Taro-Hayashi/Handyman/led_EN.md

Align the notch of the LED with the corner of the silk print and solder it.  
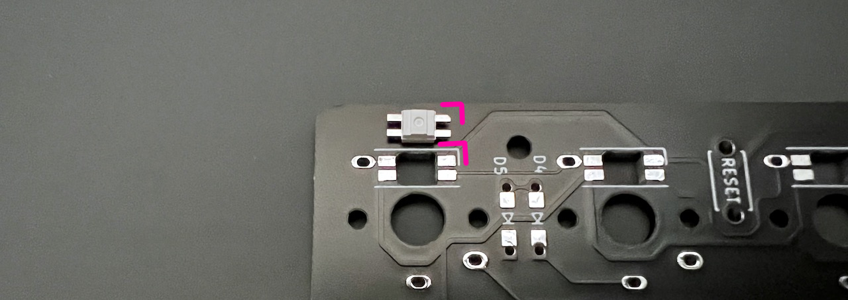
[picture p48: img/IMG_1039.jpg]
    
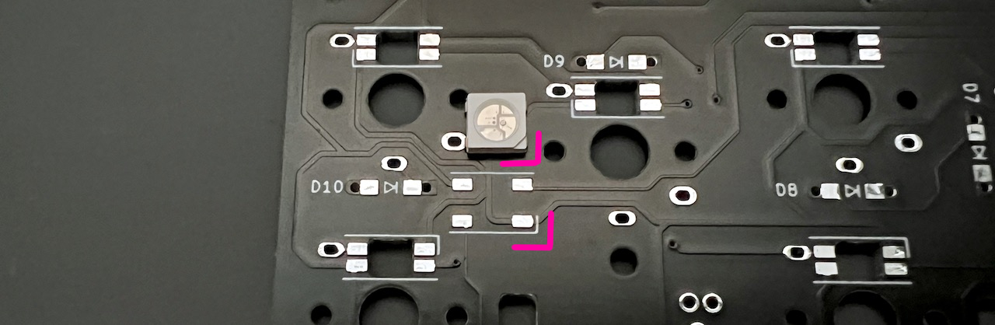
[picture p49: img/IMG_1049.jpg]
  
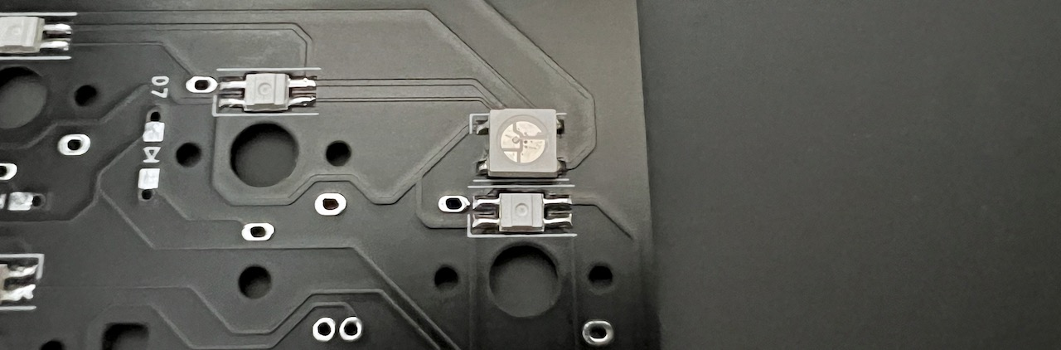
[picture p50: img/IMG_1059.jpeg]
    

Make sure the orientation is correct from the surface.
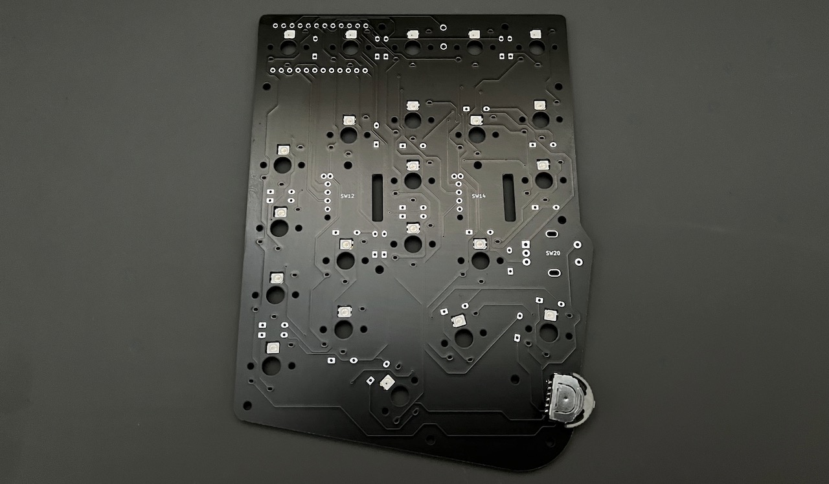
[picture p51: img/IMG_1068.jpeg]
