Taro-Hayashi/Handyman/firmware.md

## QMK Toolboxを使ったファームウェア更新方法

QMK Toolboxのreleaseページから最新版をダウンロードしてインストールください。  
- [Releases・qmk/qmk_toolbox](https://github.com/qmk/qmk_toolbox/releases)

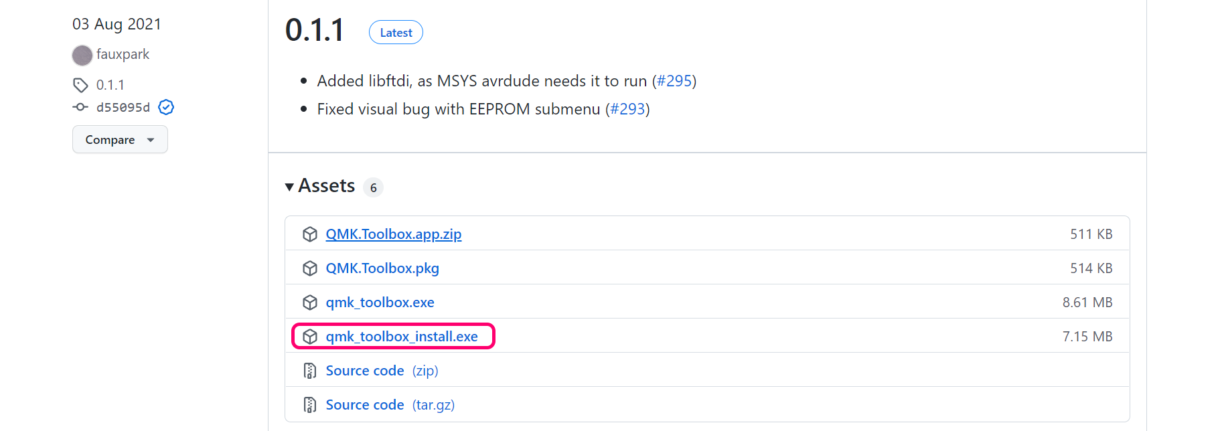
[picture p52: img/release.png]
  
起動したらOpenを押してダウンロードしたファームウェアを指定し、キーボード裏面のリセットボタンを素早く2回押します。  
   
新しく黄色の文字が出てきたらFlashを押します。  
  

Thank youの後に黄色い文字が出たら更新完了です。  
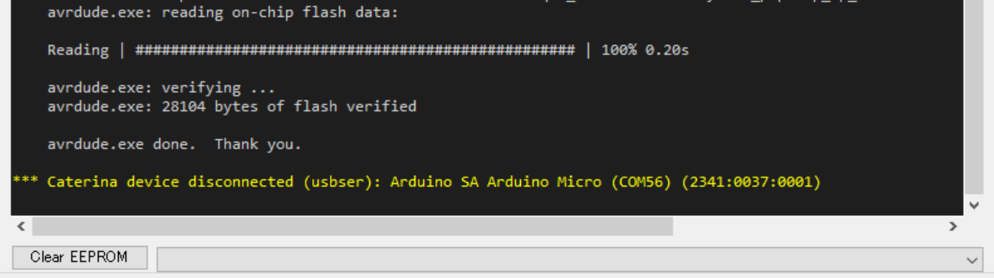
[picture p53: img/qmktoolbox3.png]
