Taro-Hayashi/Handyman/ble.md

# 電池ボックスの使い方
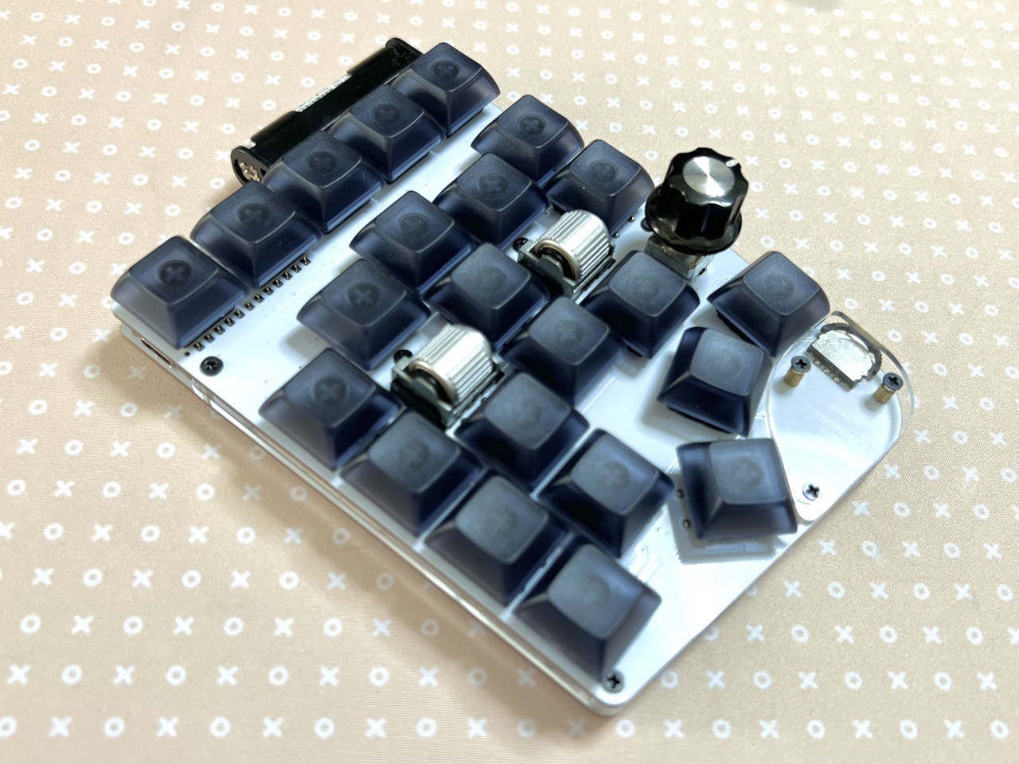
[picture p54: img/IMG_0909.jpg]


## 用意するもの
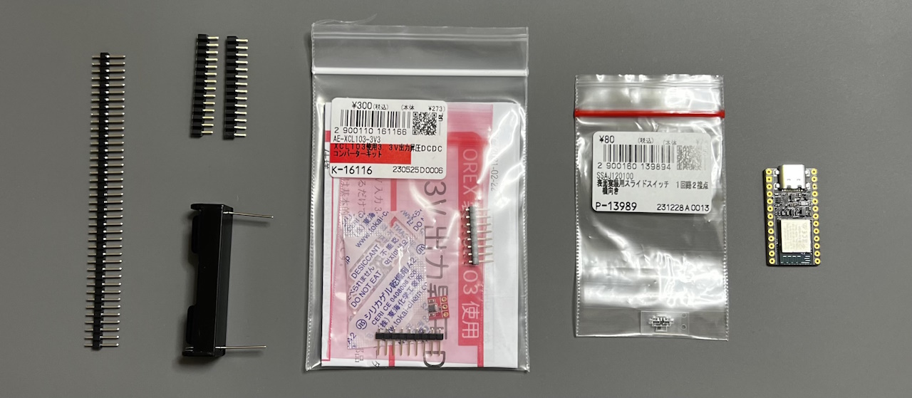
[picture p55: img/IMG_0746.jpg]


|部品（購入先の例）|個数|
|-|-|
|[ピンヘッダー](https://akizukidenshi.com/catalog/g/g100167/)|合計26ピン以上|
|[シングルピンソケット](https://akizukidenshi.com/catalog/g/g100661/)|合計26ピン以上（リンク先なら2個）|
|[電池ボックス 単4](https://akizukidenshi.com/catalog/g/g102670/)|1|
|[XCL103使用3.3V出力昇圧DCDCコンバーターキット](https://akizukidenshi.com/catalog/g/g116116/)|1|
|[スライドスイッチ](https://akizukidenshi.com/catalog/g/g113989/)|1|
|[BLE Micro Pro](https://shop.yushakobo.jp/products/ble-micro-pro)|1|

> [!NOTE]
> はんだ付けの難しいパーツがあります。  
> BLE Micro Proの使い方は製品のサイトをご覧ください。  
> ピンソケットの代わりに3.5mm コンスルーでの取り付けも可能です。

## 組み立て
スライドスイッチを取り付ける場所に予備はんだを盛ります。
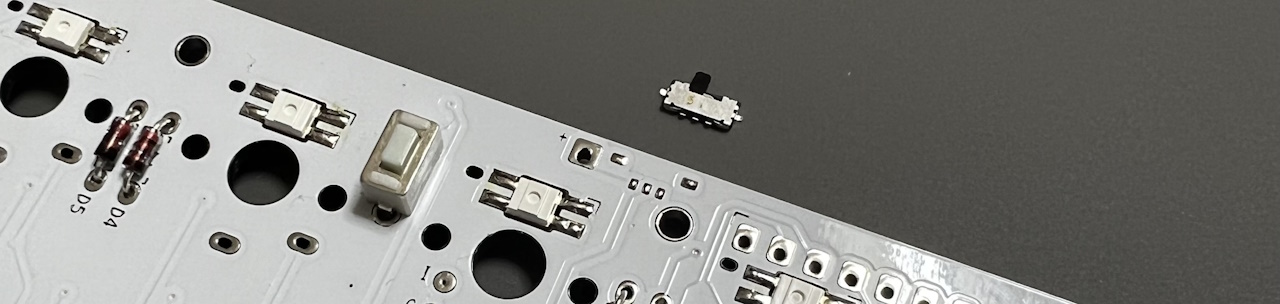
[picture p56: img/IMG_0752.jpg]


スライドスイッチをはんだ付けします。
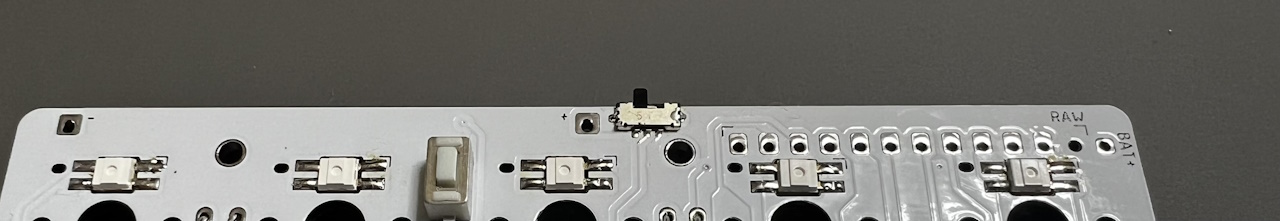
[picture p57: img/IMG_0755.jpg]


ダイオードやピンヘッダの足の切れ端をDCDCコンバーター用のパッドに立てるようにはんだ付けします。
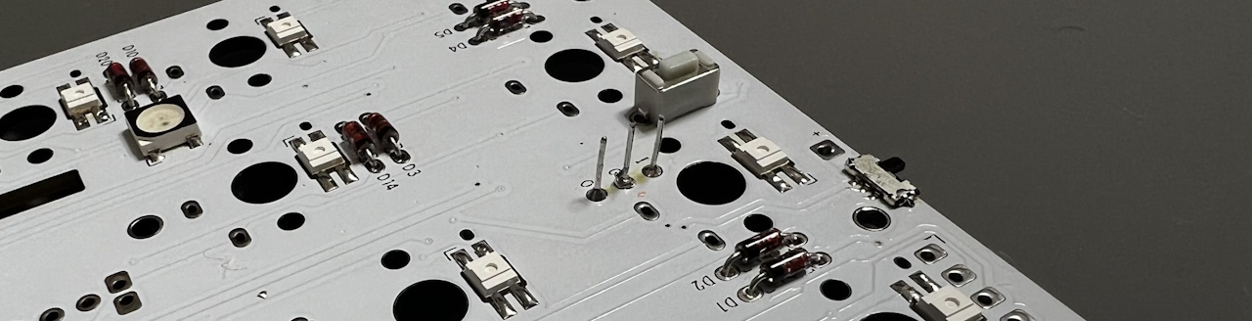
[picture p58: img/IMG_0756.jpg]


I、G、Oの位置に注意してDCDCコンバーターをはんだ付けします。

> [!NOTE]
> 出来るだけ全高が低くなるようにはんだ付けしてください。

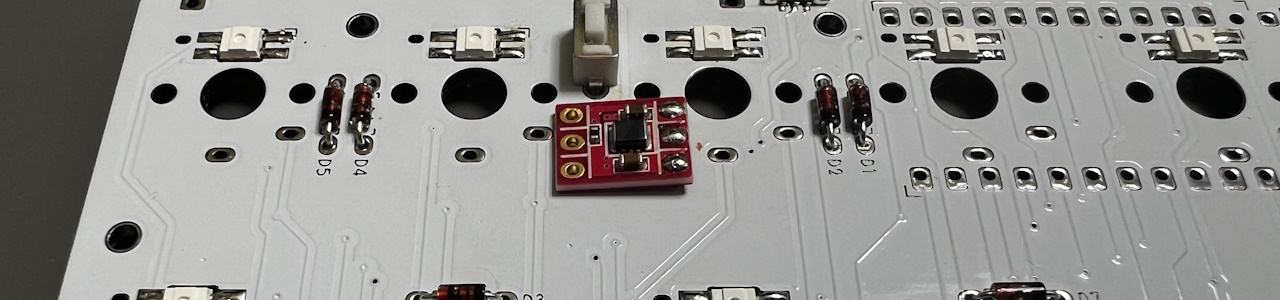
[picture p59: img/IMG_0758.jpg]

BLE Micro Proにピンソケットをのせ、ピンヘッダを差し込みます。

> [!WARNING]
> 上下に気を付けてください。

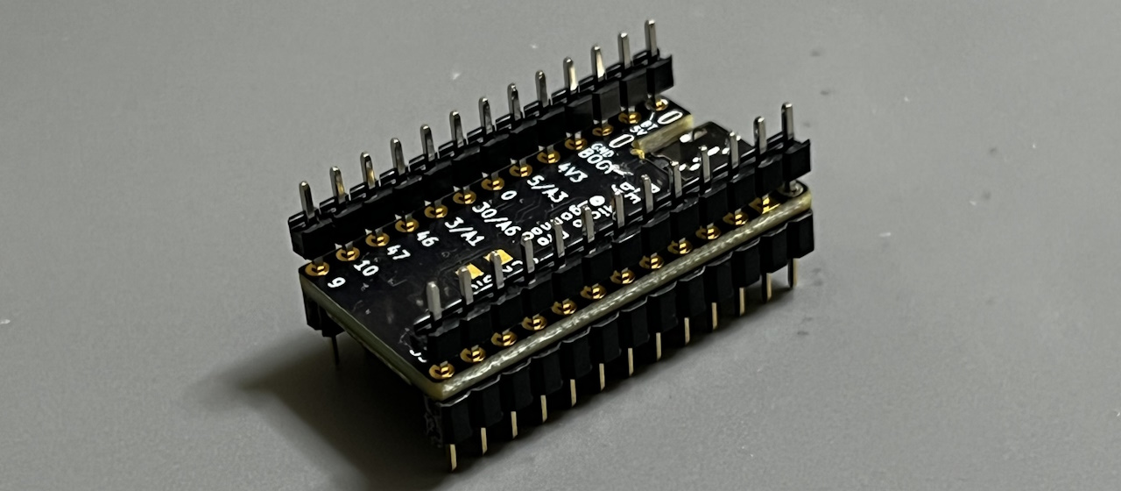
[picture p60: img/IMG_0772.jpg]

メインボードに差し込み表裏共にはんだ付けします。ピンヘッダは足を切りました。

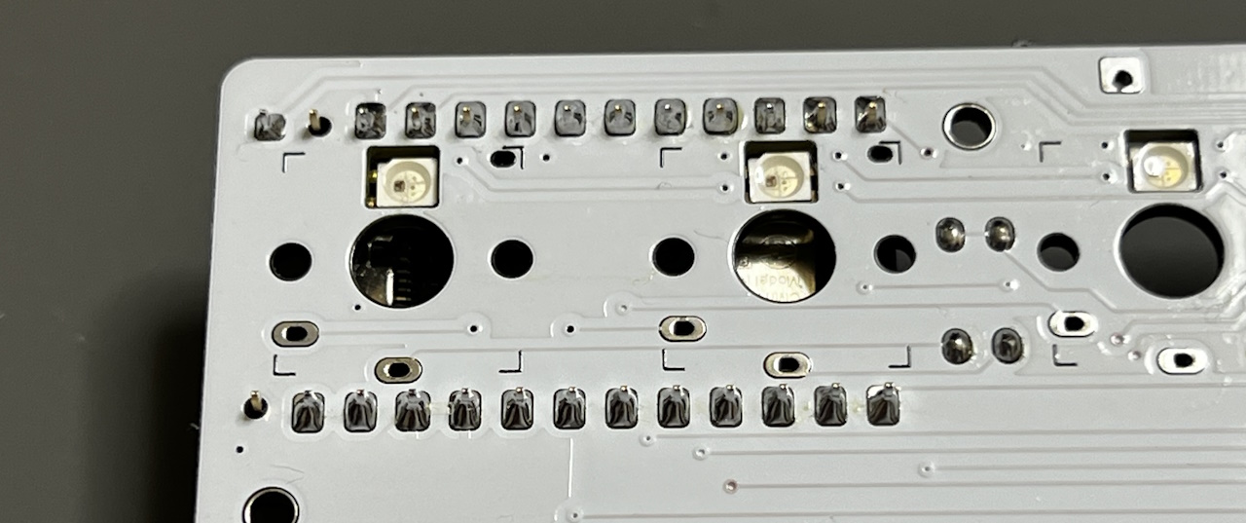
[picture p61: img/IMG_0773.jpg]

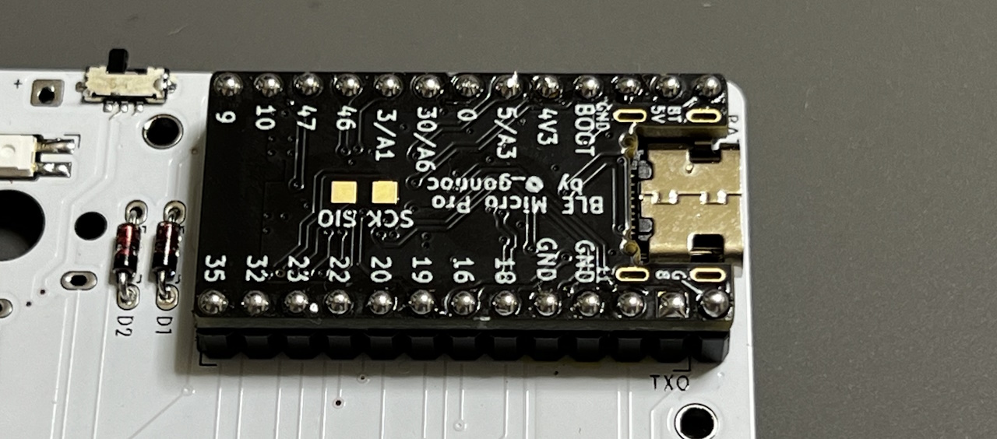
[picture p62: img/IMG_0777.jpg]

電池ボックスのピンを曲げて差し込みます。

> [!WARNING]
> ＋－に気を付けてください。

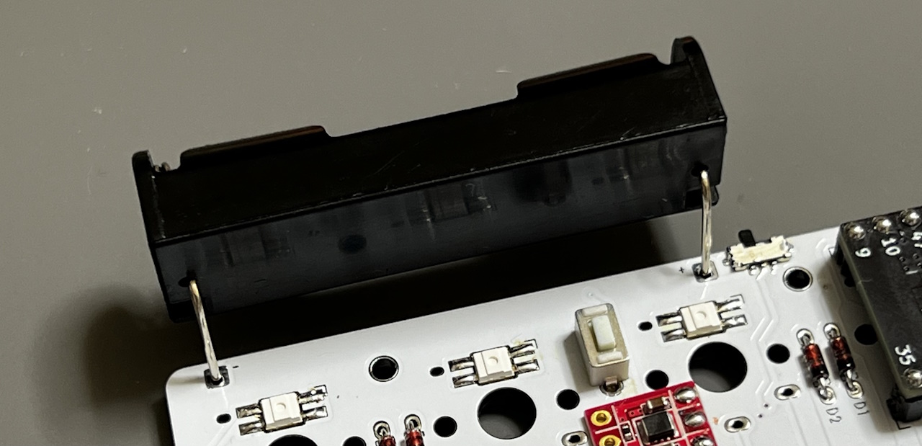
[picture p63: img/IMG_0779.jpg]

両面をはんだ付けします。
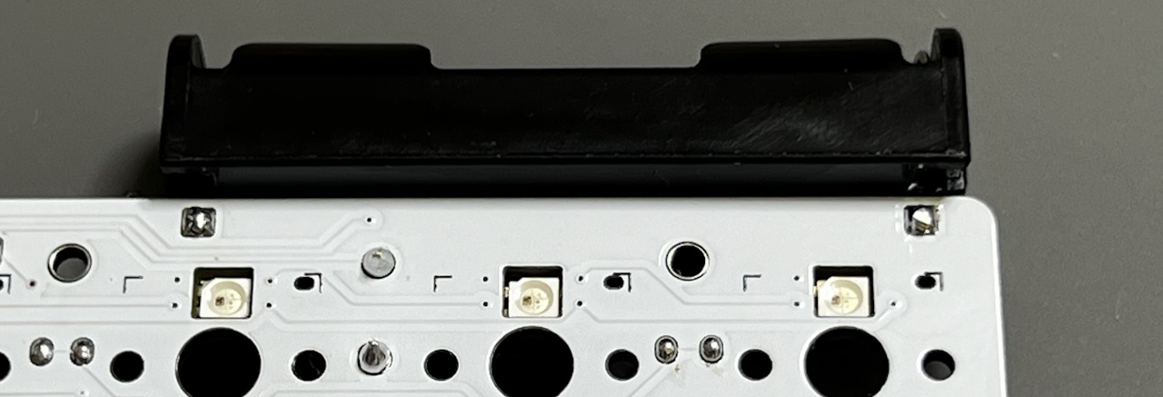
[picture p64: img/IMG_0782.jpg]

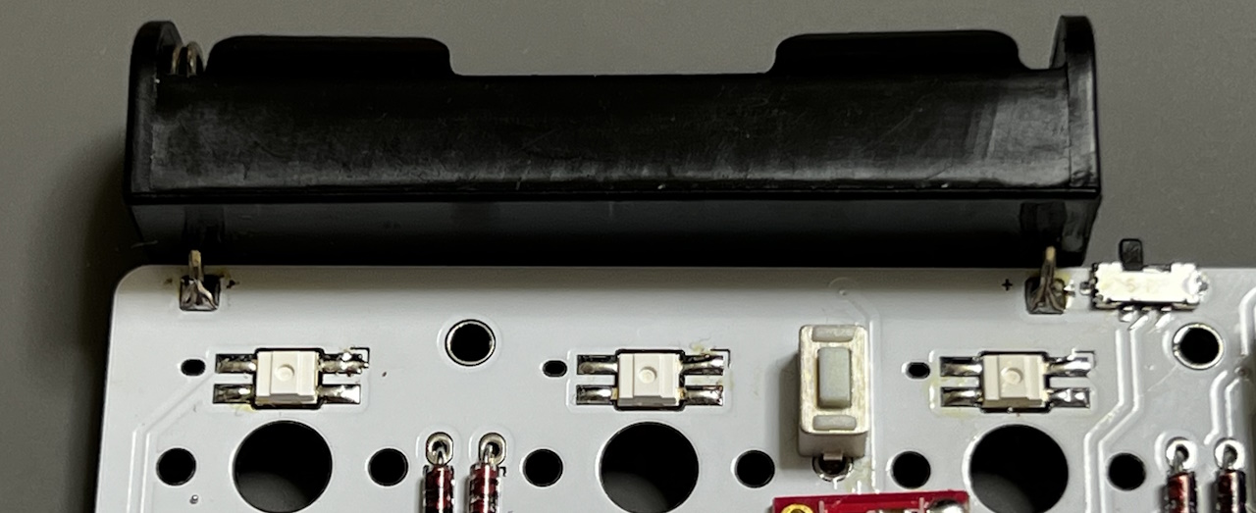
[picture p65: img/IMG_0785.jpg]


電池を入れてスライドスイッチを電池ボックス側に倒すと電源が入ります。  
電圧は画像のようになるのでテスターでチェックする時は参考にしてください。
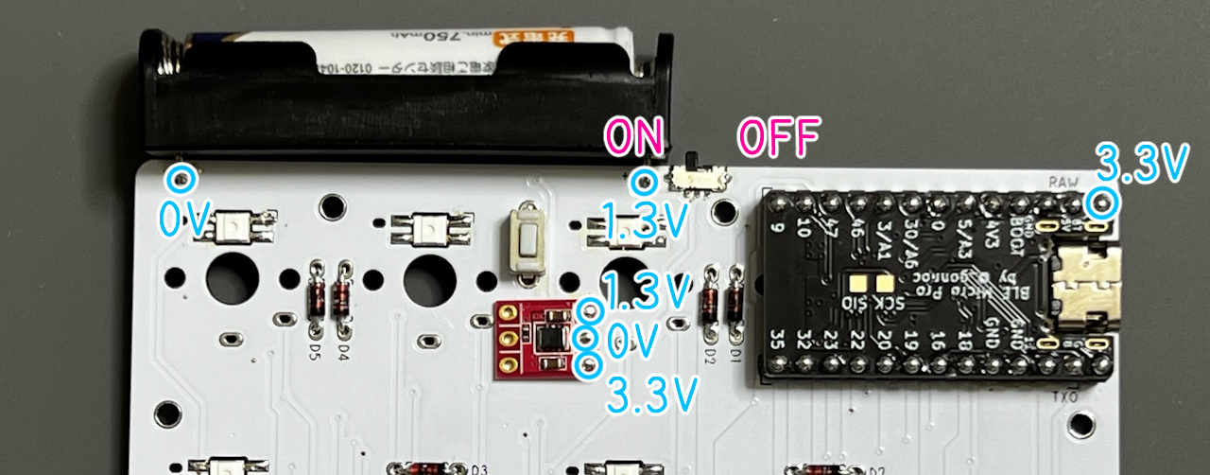
[picture p66: img/IMG_0787.jpg]

  
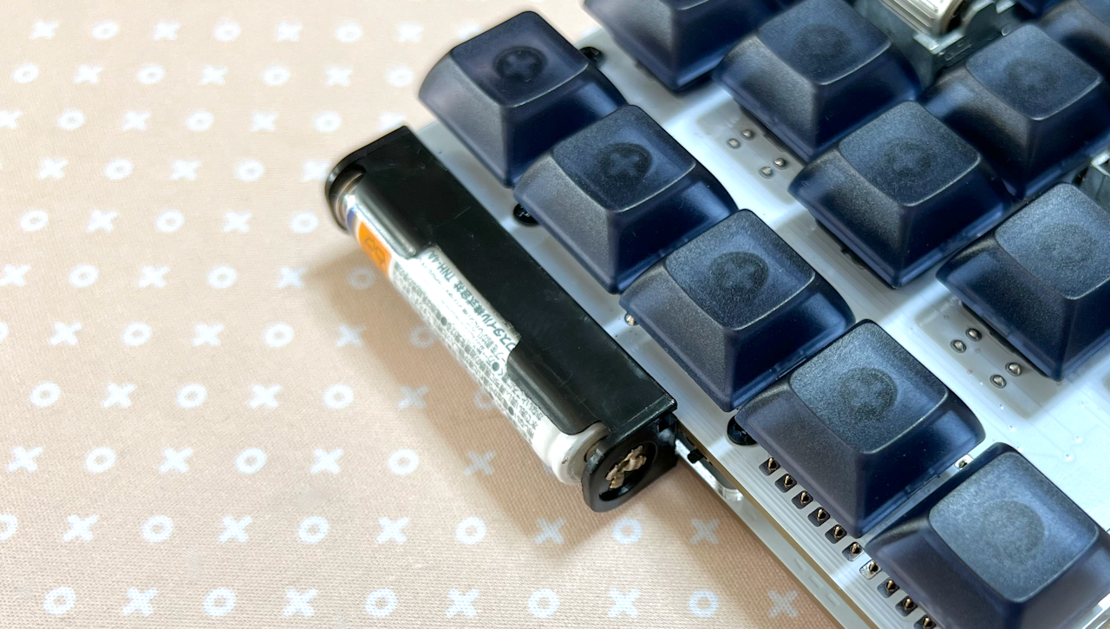
[picture p67: img/box.png]
