Taro-Hayashi/Handyman/img/handyman.jpg

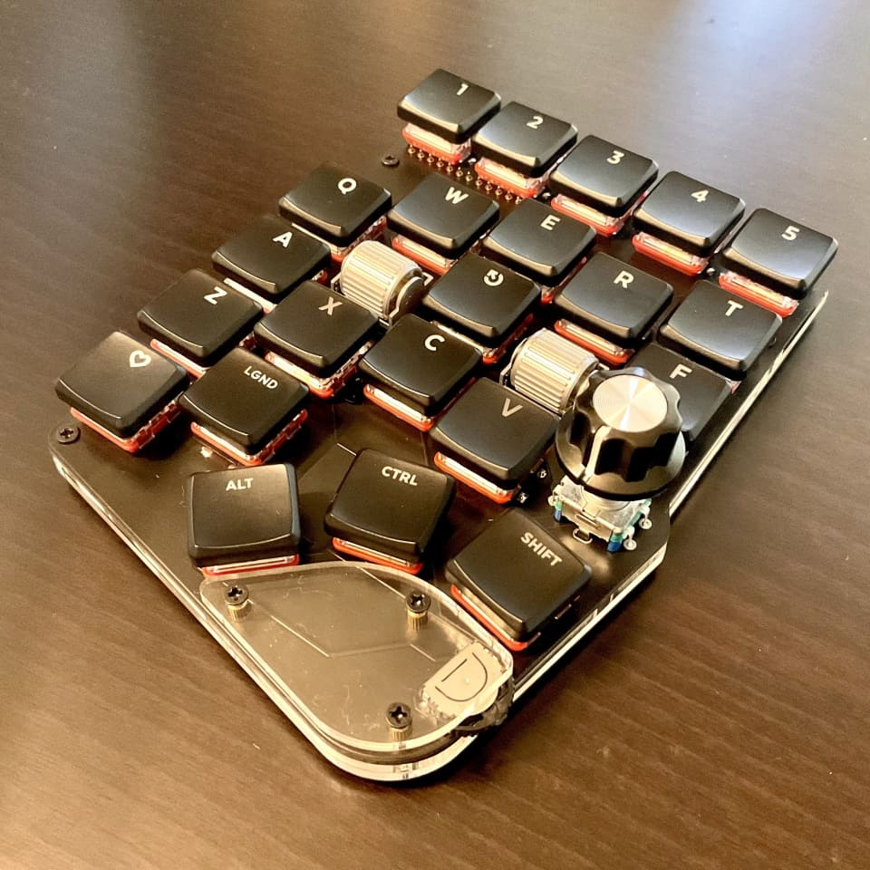
img/handyman.jpg
