Taro-Hayashi/Handyman/img/IMG_0793.jpg

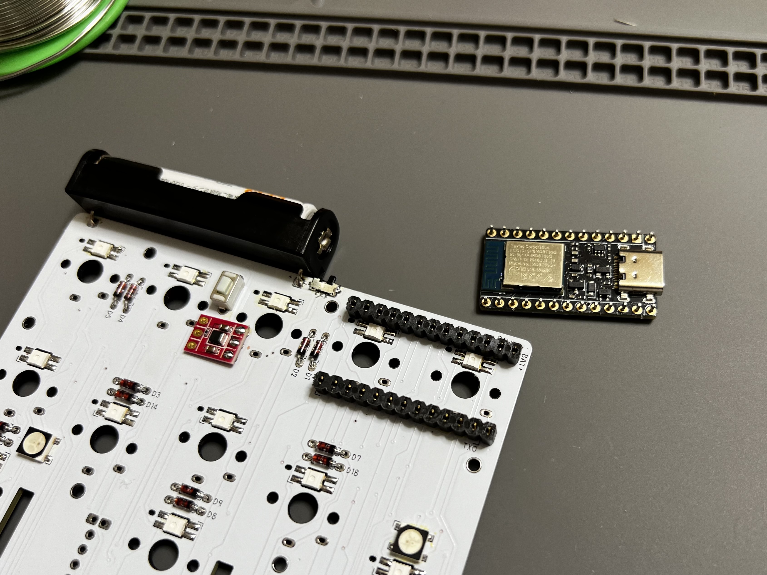
img/IMG_0793.jpg
