Taro-Hayashi/Handyman/img/IMG_0795.jpg

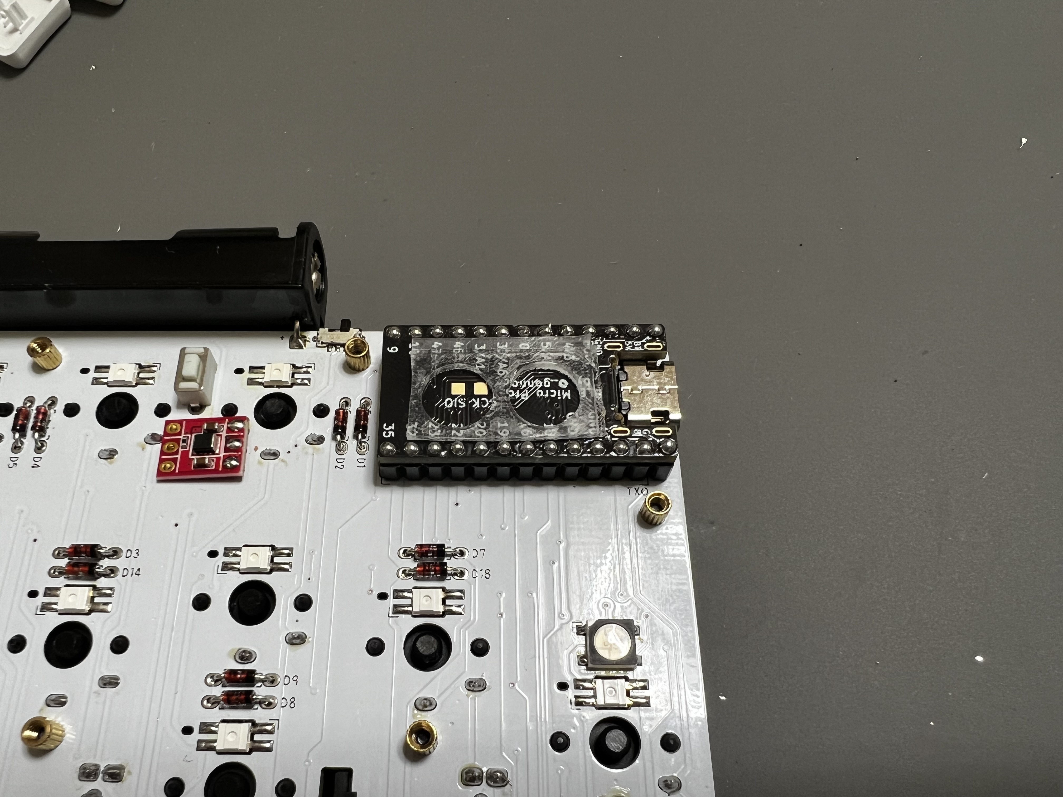
img/IMG_0795.jpg
