Taro-Hayashi/Handyman/img/IMG_1175.jpeg

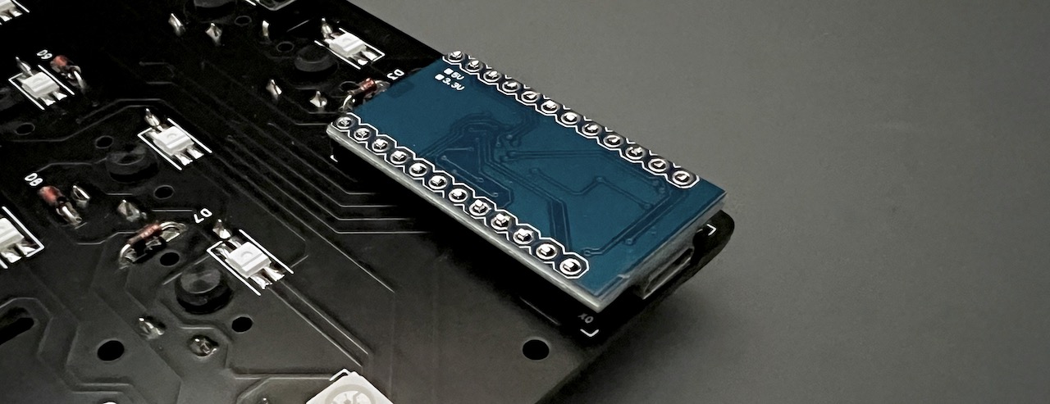
img/IMG_1175.jpeg
