Taro-Hayashi/Handyman/img/IMG_1176.jpeg

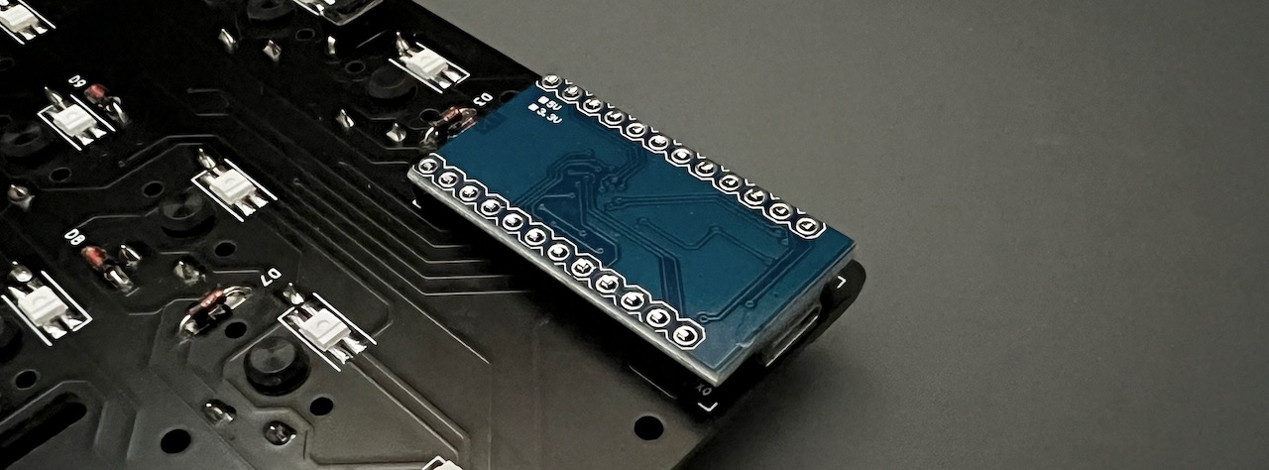
img/IMG_1176.jpeg
