Taro-Hayashi/Handyman/img/IMG_1214.jpeg

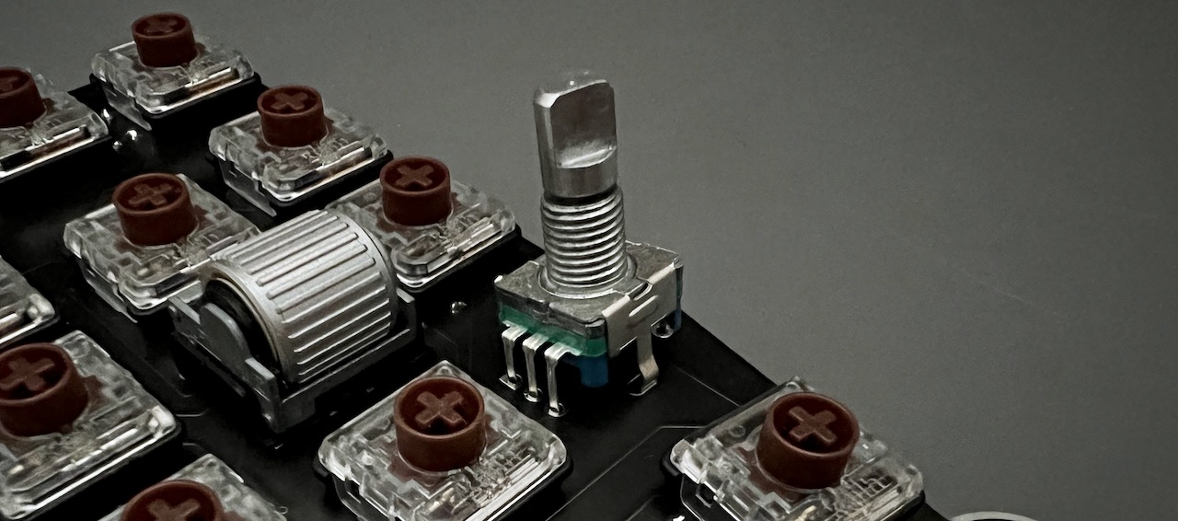
img/IMG_1214.jpeg
