Taro-Hayashi/Handyman/img/re.jpg

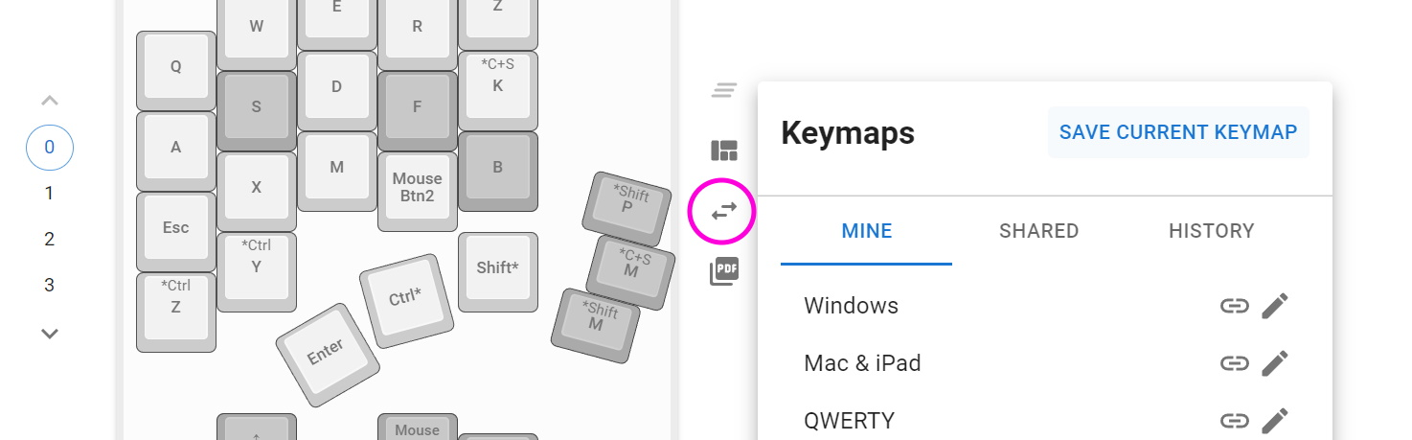
img/re.jpg
