Taro-Hayashi/Handyman/preassembled.md

# Handyman マクロパッド 取り扱い説明書

## 内容品
- Handyman マクロパッド 1個

 
  
## ご用意いただくもの
- Type-C USBケーブル
- Windows/Mac/Linux（iPad、Androidでも使用できますが設定ができません）

## ファームウェアの書き込み
まず動作ソフト（ファームウェア）をHandymanに書き込みます。  
Google ChromeかMicrosoft Edgeでこちらにアクセスし、Remap用ファームウェアのFlashをクリックします。

- https://remap-keys.app/catalog/dTmFWd6gilf5ziDWE1TR/firmware

 
 
このような画面が出てくるのでキット裏面のリセットスイッチを２回素早く押すと新しく項目が出てきます。
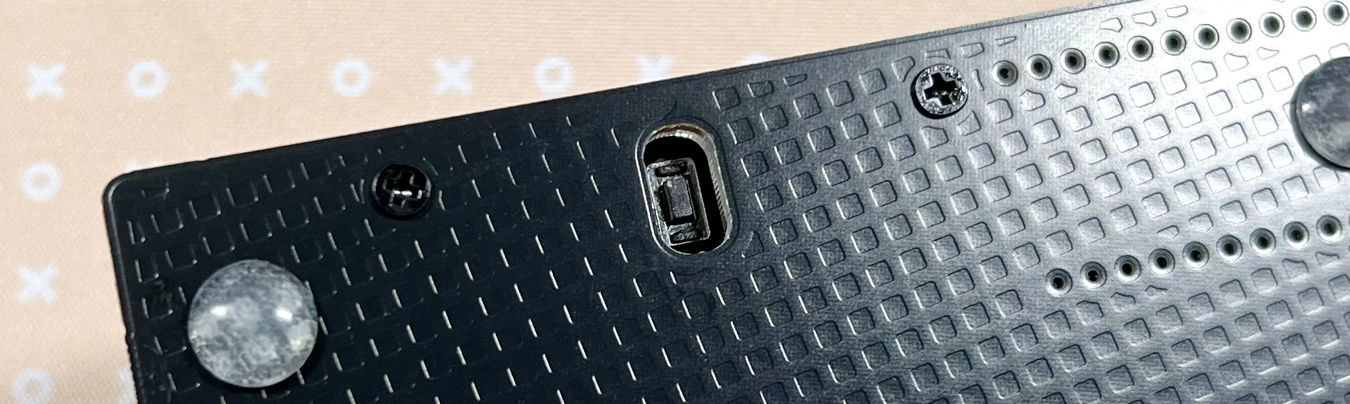
[picture p75: img/ura.jpg]
 
 

選択して接続を押すと書き込みが始まります。

 
CLOSEを押してファームウエアの書き込みは完了です。

## キーのカスタマイズ

Google ChromeかMicrosoft Edgeでこちらにアクセスしてください。
- Remap https://remap-keys.app

  
左を選んで進んでいくとキーボードを選択できます。  
  
選択して接続してください。
  

標準ではUS配列設定でのClip Studio Paintにあわせたキーマップになっています。  

### キーマップの保存と復元
⇔アイコンで作ったキーマップを保存することができます。  
  
作ったキーマップを共有することもできるので是非お試しください。

### 左右を変える
レイアウトオプションで左右を変えることができます。  
  

### キーを設定する
下のキー一覧からドラッグアンドドロップし、変更が終わったら右上のflashボタンを押すと反映されます。  
  
また、USキーボードとJISキーボードはFlashの下のプルダウンから変更できます。OSの設定に合わせてください。

### 修飾キーとの組み合わせを設定する
キーボードのキーをクリックすると設定画面になります。
  
修飾キーと同時押ししたいキーを検索し、同時押ししたい修飾キーにチェックを入れます。
  

Hold-Tapもここから設定できます。

### ロータリーエンコーダーを設定する
丸いキーの左下をクリックすると時計回り、反時計回り、押し込みを切り替えることができるので、それぞれにキーを割り当てます。
  

### 特殊なキーを設定する
FUNCTIONSタブのVIA USER KEYにあらかじめ用意されたショートカットキーがあります。
  

### LEDを調整する
このボタンで発光方法を変更することができます。
  

## その他
### キーキャップの引き抜き方
スイッチはキーキャップ側から見て下部の2点ではんだ付けされています。上部を持ち上げるように手前に引っ張ると金具が曲がり隙間が出来てしまうことがあります。
キーキャップ引き抜き用の工具を使い側面を掴み垂直に引き抜く事を意識すると抜きやすいです。
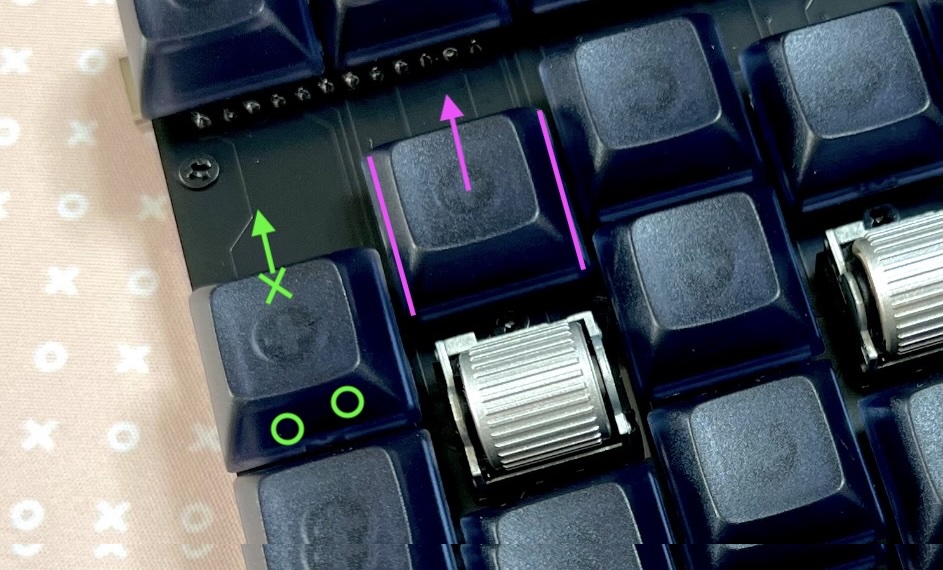
[picture p76: img/pull.jpg]
  

### ファームウェアのフォルダ  
https://github.com/Taro-Hayashi/qmk_firmware/tree/tarohayashi/keyboards/tarohayashi/handyman

### 販売サイト
- BOOTH: https://tarohayashi.booth.pm/items/3208122
