Taro-Hayashi/Handyman/(threads)

Thread 1 (2021-12-30):

画像内容の間違い

SuperTaiyaki, 2021-12-30:
大した問題ではありませんが、組立中にちょっと引っかかった２点です。
IMG_5108.jpgでURAと書いてありますが、表です。
IMG_5131.jpgで、左上のスペーサーに青いマルはありません

Taro-Hayashi, 2021-12-30:
ご報告ありがとうございます！混乱させてしまい申し訳ありませんでした。
見直してみたところ裏ではないのにURAになっている画像は他にもありました。近日中に直します。

Taro-Hayashi, 2021-12-31:
プルリクもありがとうございました！他の画像も訂正しました。

Closed 2021-12-31.
