Taro-Hayashi/Handyman/KiCad/handyman_r.kicad_pcb

## KiCad design KiCad/handyman_r.kicad_pcb (2026-05-24)

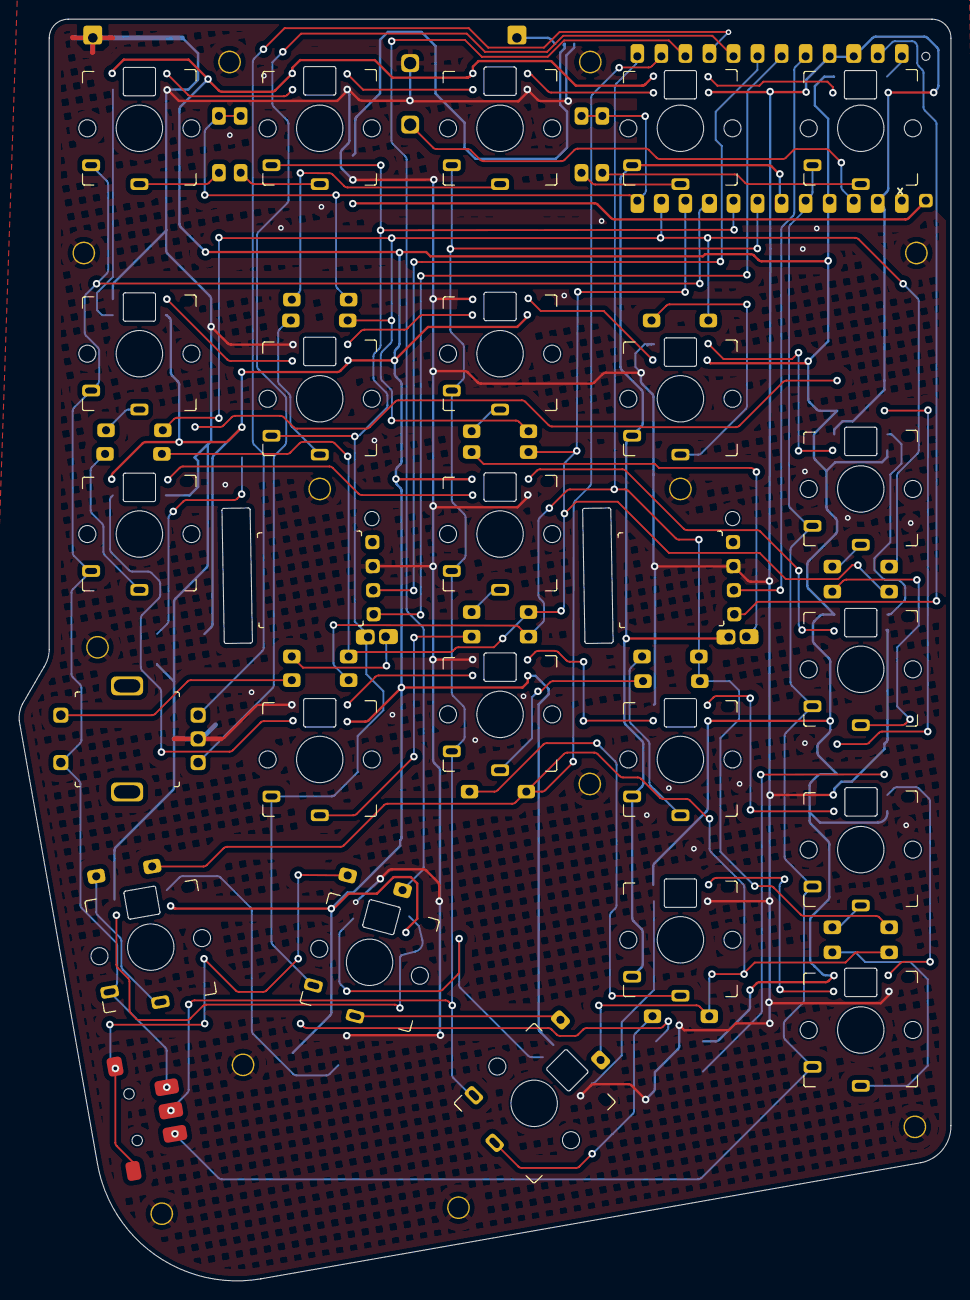
[picture p77: board handyman_r.kicad_pcb from above]

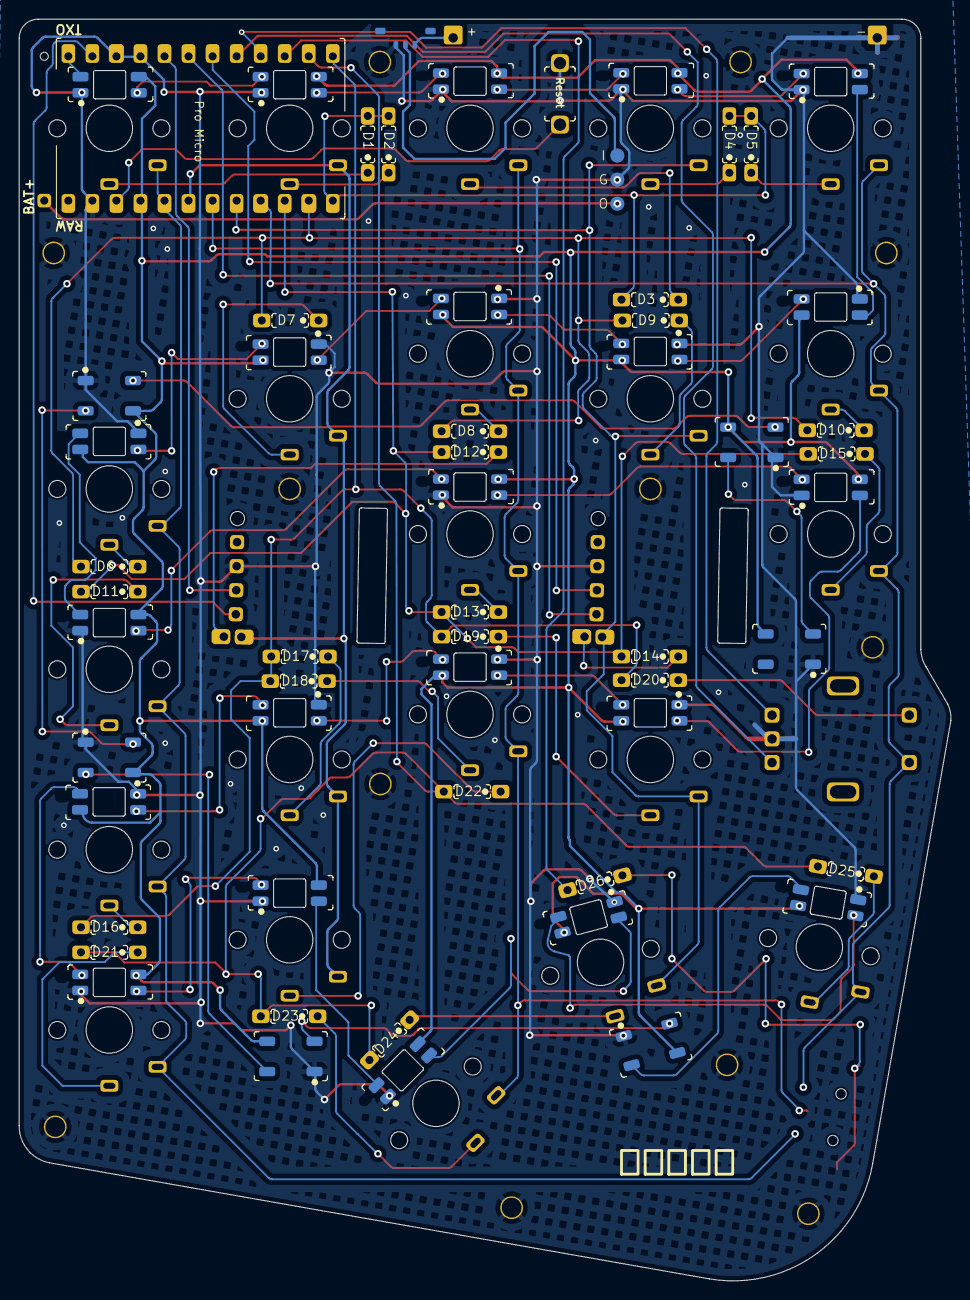
[picture p78: board handyman_r.kicad_pcb from below]

Board: 2 copper layers, 98.4 x 133.3 mm, 94 parts (67 on the bottom side), 74 nets.

Parts:
BL1, BL2, BL3, BL4, BL5, BL6, BL7, BL8, BL9, BL10, BL11, BL12, BL13, BL14, BL15, BL16, BL17, BL18, BL19, BL20, BL21, BL22: SK6812MINI-E; LED_SK6812MINI-E_Backlight
D1, D2, D3, D4, D5, D6, D7, D8, D9, D10, D11, D12, D13, D14, D15, D16, D17, D18, D19, D20, D21, D22, D23, D24, D25, D26: D; DIP_Diode 2
H1, H2, H3, H4, H5, H6, H7, H8, H9, H10, H11, H12: Hole; Hole_2mm_M2_PTH
Knob: Rotary_Encoder; Encoder_EC11
RST1: Reset; Switch_Reset 2
S**: SLLB120100; Switch_SLLB120100
SW1, SW2, SW3, SW4, SW5, SW6, SW7, SW8, SW9, SW10, SW11, SW13, SW15, SW16, SW17, SW18, SW19, SW21, SW22, SW23, SW24, SW25: SW_PUSH; Switch_Choc_V2only
SW12, SW14: EVQWGD001; Encoder_EVQWGD001
U1: ProMicro; MCU_BLE_Micro_Pro
UG1, UG2, UG3, UG4, UG5, UG6: WS2812B; LED_WS2812B 2

Connections:
GND: BL1.3, BL2.3, BL3.3, BL4.3, BL5.3, BL6.3, BL7.3, BL8.3, BL9.3, BL10.3, BL11.3, BL12.3, BL13.3, BL14.3, BL15.3, BL16.3, BL17.3, BL18.3, BL19.3, BL20.3, BL21.3, BL22.3, H1.1, H2.1, H3.1, H4.1, H5.1, H6.1, H7.1, H8.1, H9.1, H10.1, H11.1, H12.1, Knob.C, RST1.2, SW12.5, SW14.5, U1.3, U1.4, U1.23, UG1.3, UG2.3, UG3.3, UG4.3, UG5.3, UG6.3
unnamed: BL1.2, BL2.4
unnamed: BL2.2, BL3.4
unnamed: BL3.2, BL4.4
unnamed: BL4.2, BL5.4
unnamed: BL6.4, BL7.2
unnamed: BL7.4, BL8.2
unnamed: BL8.4, BL9.2
unnamed: BL9.4, BL10.2
unnamed: BL5.2, BL10.4
unnamed: BL11.2, BL12.4
unnamed: BL6.2, BL11.4
unnamed: BL12.2, BL13.4
unnamed: BL13.2, BL17.4
unnamed: BL14.2, BL18.4
unnamed: BL14.4, BL15.2
unnamed: BL15.4, BL16.2
unnamed: BL16.4, BL17.2
unnamed: BL18.2, BL19.4
unnamed: BL19.2, BL20.4
unnamed: BL20.2, BL21.4
unnamed: BL21.2, BL22.4
unnamed: BL22.2, UG6.4
unnamed: D1.1, SW1.2
unnamed: D2.1, SW2.2
unnamed: D3.1, SW3.2
unnamed: D4.1, SW4.2
unnamed: D5.1, SW5.2
unnamed: D6.1, SW6.2
unnamed: D7.1, SW7.2
unnamed: D8.1, SW8.2
unnamed: D9.1, SW9.2
unnamed: D10.1, SW10.2
unnamed: D11.1, SW11.2
unnamed: D12.1, SW12.1
unnamed: D13.1, SW13.2
unnamed: D14.1, SW14.1
unnamed: D15.1, SW15.2
unnamed: D16.1, SW16.2
unnamed: D17.1, SW17.2
unnamed: D18.1, SW18.2
unnamed: D19.1, SW19.2
unnamed: D20.1, Knob.S1
unnamed: D21.1, SW21.2
unnamed: D22.1, SW22.2
unnamed: D23.1, SW23.2
unnamed: D24.1, SW24.2
unnamed: D25.1, SW25.2
unnamed: UG1.4, UG2.2
unnamed: UG2.4, UG3.2
unnamed: UG3.4, UG4.2
unnamed: UG4.4, UG5.2
unnamed: UG5.4, UG6.2
VCC: BL1.1, BL2.1, BL3.1, BL4.1, BL5.1, BL6.1, BL7.1, BL8.1, BL9.1, BL10.1, BL11.1, BL12.1, BL13.1, BL14.1, BL15.1, BL16.1, BL17.1, BL18.1, BL19.1, BL20.1, BL21.1, BL22.1, U1.21, UG1.1, UG2.1, UG3.1, UG4.1, UG5.1, UG6.1
col0: S**.1, SW1.1, SW6.1, SW11.1, SW16.1, SW21.1, U1.20
col1: SW2.1, SW7.1, SW12.2, SW17.1, SW22.1, U1.19
col2: S**.3, SW3.1, SW8.1, SW13.1, SW18.1, SW23.1, U1.18
col3: SW4.1, SW9.1, SW14.2, SW19.1, SW24.1, U1.17
col4: Knob.S2, S**.2, SW5.1, SW10.1, SW15.1, SW25.1, U1.16
lbc1: D26.1, S**.4
led: BL1.4, U1.1
reset: RST1.1, U1.22
ro1a: SW12.3, U1.2
ro1b: SW12.4, U1.5
ro2a: SW14.3, U1.6
ro2b: SW14.4, U1.7
ro3a: Knob.A, U1.8
ro3b: Knob.B, U1.9
row0: D1.2, D2.2, D3.2, D4.2, D5.2, U1.13
row1: D6.2, D7.2, D8.2, D9.2, D10.2, U1.14
row2: D11.2, D12.2, D13.2, D14.2, D15.2, U1.15
row3: D16.2, D17.2, D18.2, D19.2, D20.2, U1.12
row4: D21.2, D22.2, D23.2, D24.2, D25.2, U1.11
row5: D26.2, U1.10
